hoeken/ESP32-S3-Template/ESP32-S3-Template.kicad_pcb

## KiCad design ESP32-S3-Template.kicad_pcb (2025-10-02)

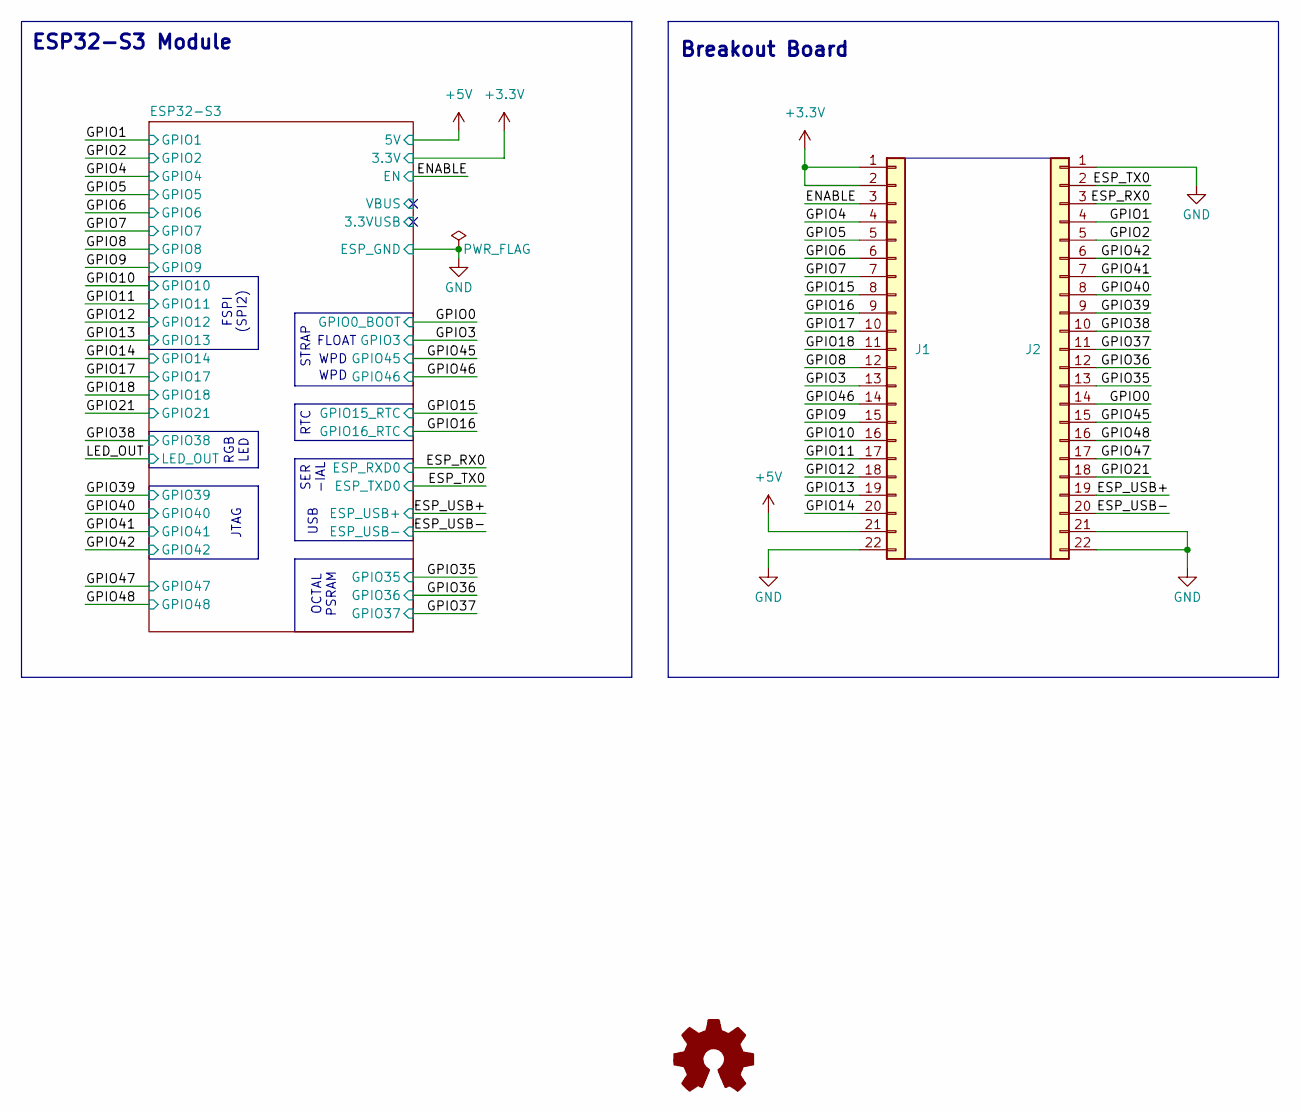
[picture p1: schematic ESP32-S3-Template.kicad_sch]

Parts:
J1, J2: Conn_01x22; PinHeader_1x22_P2.54mm_Vertical
S1: Logo_Open_Hardware_Small; OSHW-Logo_5.7x6mm_SilkScreen

Connections:
+3.3V: J1.1, J1.2; also elsewhere on the board
+5V: J1.21; also elsewhere on the board
/ENABLE: J1.3; also elsewhere on the board
/ESP_RX0: J2.3; also elsewhere on the board
/ESP_TX0: J2.2; also elsewhere on the board
/ESP_USB+: J2.19; also elsewhere on the board
/ESP_USB-: J2.20; also elsewhere on the board
/GPIO0: J2.14; also elsewhere on the board
/GPIO1: J2.4; also elsewhere on the board
/GPIO2: J2.5; also elsewhere on the board
/GPIO3: J1.13; also elsewhere on the board
/GPIO4: J1.4; also elsewhere on the board
/GPIO5: J1.5; also elsewhere on the board
/GPIO6: J1.6; also elsewhere on the board
/GPIO7: J1.7; also elsewhere on the board
/GPIO8: J1.12; also elsewhere on the board
/GPIO9: J1.15; also elsewhere on the board
/GPIO10: J1.16; also elsewhere on the board
/GPIO11: J1.17; also elsewhere on the board
/GPIO12: J1.18; also elsewhere on the board
/GPIO13: J1.19; also elsewhere on the board
/GPIO14: J1.20; also elsewhere on the board
/GPIO15: J1.8; also elsewhere on the board
/GPIO16: J1.9; also elsewhere on the board
/GPIO17: J1.10; also elsewhere on the board
/GPIO18: J1.11; also elsewhere on the board
/GPIO21: J2.18; also elsewhere on the board
/GPIO35: J2.13; also elsewhere on the board
/GPIO36: J2.12; also elsewhere on the board
/GPIO37: J2.11; also elsewhere on the board
/GPIO38: J2.10; also elsewhere on the board
/GPIO39: J2.9; also elsewhere on the board
/GPIO40: J2.8; also elsewhere on the board
/GPIO41: J2.7; also elsewhere on the board
/GPIO42: J2.6; also elsewhere on the board
/GPIO45: J2.15; also elsewhere on the board
/GPIO46: J1.14; also elsewhere on the board
/GPIO47: J2.17; also elsewhere on the board
/GPIO48: J2.16; also elsewhere on the board
GND: J1.22, J2.1, J2.21, J2.22; also elsewhere on the board

Notes on the sheet:
RTC
FSPI (SPI2)
WPD
FLOAT
Breakout Board
STRAP
ESP32-S3 Module
RGB LED
JTAG
OCTAL PSRAM
SER -IAL
USB

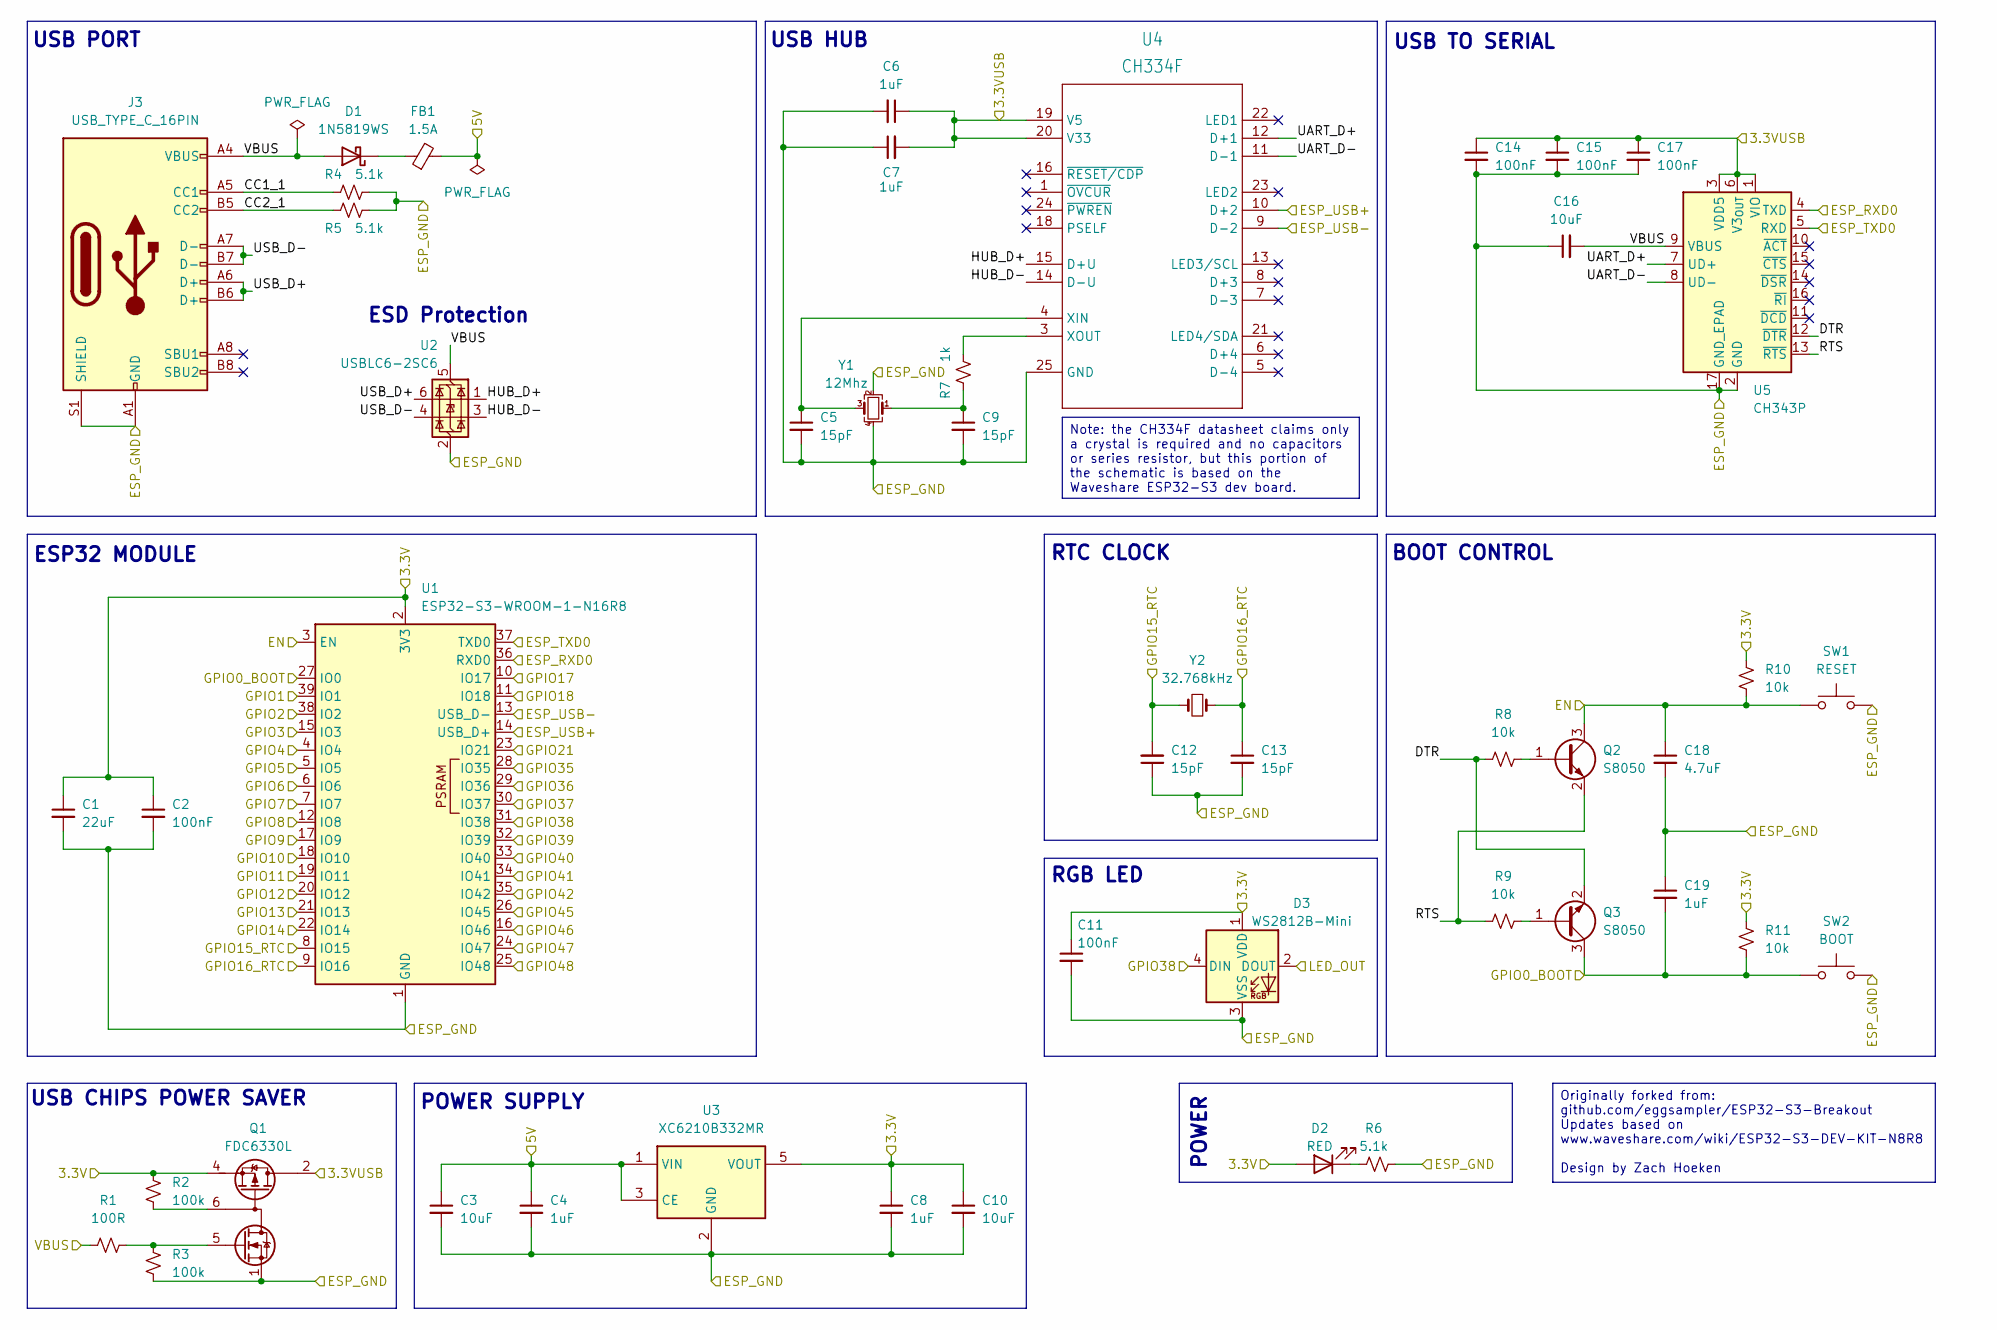
[picture p2: schematic esp32-s3.kicad_sch, https://github.com/hoeken/ESP32-S3-Template]

Parts:
C1: 22uF; C_0603_1608Metric
C2, C11, C14, C15, C17: 100nF; C_0603_1608Metric
C3, C10, C16: 10uF; C_0603_1608Metric
C4, C6, C7, C8, C19: 1uF; C_0603_1608Metric
C5, C9, C12, C13: 15pF; C_0603_1608Metric
C18: 4.7uF; C_0603_1608Metric
D1: 1N5819WS; D_SOD-323; LCSC C191023
D2: RED; LED_0603_1608Metric; LCSC C965799
D3: WS2812B-Mini; LED_WS2812B-Mini_PLCC4_3.5x3.5mm; LCSC C527089
FB1: 1.5A; Fuse_1206_3216Metric; LCSC C2760275
J3: USB_TYPE_C_16PIN; USB_C_Receptacle_GCT_USB4105-xx-A_16P_TopMnt_Horizontal; LCSC C393939
Q1: FDC6330L; TSOT-23-6; LCSC C112086
Q2, Q3: S8050; SOT-23; LCSC C916390
R1: 100R; R_0603_1608Metric
R2, R3: 100k; R_0603_1608Metric
R4, R5, R6: 5.1k; R_0603_1608Metric
R7: 1k; R_0603_1608Metric
R8, R9, R10, R11: 10k; R_0603_1608Metric
SW1: RESET; SW_Tactile_SPST_Angled_PTS645Vx58-2LFS; LCSC C557599
SW2: BOOT; SW_Tactile_SPST_Angled_PTS645Vx58-2LFS; LCSC C557599
U1: ESP32-S3-WROOM-1-N16R8; ESP32-S3-WROOM-1; LCSC C2913202
U2: USBLC6-2SC6; SOT-23-6; LCSC C7519
U3: XC6210B332MR; SOT-23-5; LCSC C424705
U4: CH334F; QFN-24-1EP_4x4mm_P0.5mm_EP2.7x2.7mm_ThermalVias; LCSC C5187527
U5: CH343P; QFN-16-1EP_3x3mm_P0.5mm_EP1.7x1.7mm_ThermalVias; LCSC C2846043
Y1: 12Mhz; Crystal_SMD_SeikoEpson_TSX3225-4Pin_3.2x2.5mm; LCSC C9002
Y2: 32.768kHz; Crystal_SMD_3215-2Pin_3.2x1.5mm; LCSC C97606

Connections:
+3.3V: C1.1, C2.1, C8.1, C10.1, C11.1, D2.2 (A), D3.1 (VDD), Q1.4 (S2), R2.2, R10.1, R11.2, U1.2 (3V3), U3.5 (VOUT); also elsewhere on the board
+5V: C3.1, C4.1, FB1.2, U3.1 (VIN), U3.3 (CE); also elsewhere on the board
/ENABLE: C18.1, Q2.3 (C), R10.2, SW1.1, U1.3 (EN); also elsewhere on the board
/ESP32-S3/3.3VUSB: C6.1, C7.2, C14.1, C15.1, C17.1, Q1.2 (D2), Q1.3 (D2), U4.19 (V5), U4.20 (V33), U5.1 (VIO), U5.3 (VDD5), U5.6 (V3_{OUT})
/ESP32-S3/CC1_1: J3.A5 (CC1), R4.1
/ESP32-S3/CC2_1: J3.B5 (CC2), R5.1
/ESP32-S3/DTR: Q3.2 (E), R8.1, U5.12 (~DTR)
/ESP32-S3/HUB_D+: U2.1 (I/O1), U4.15 (D+U)
/ESP32-S3/HUB_D-: U2.3 (I/O2), U4.14 (D-U)
/ESP32-S3/RTS: Q2.2 (E), R9.1, U5.13 (~RTS)
/ESP32-S3/UART_D+: U4.12 (D+1), U5.7 (UD+)
/ESP32-S3/UART_D-: U4.11 (D-1), U5.8 (UD-)
/ESP32-S3/USB_D+: J3.A6 (D+), J3.B6 (D+), U2.6 (I/O1)
/ESP32-S3/USB_D-: J3.A7 (D-), J3.B7 (D-), U2.4 (I/O2)
/ESP32-S3/VBUS: C16.2, D1.2 (A), J3.A4 (VBUS), J3.A9 (VBUS), J3.B4 (VBUS), J3.B9 (VBUS), R1.2, U2.5 (VBUS), U5.9 (VBUS)
/ESP_RX0: U1.36 (RXD0), U5.4 (TXD); also elsewhere on the board
/ESP_TX0: U1.37 (TXD0), U5.5 (RXD); also elsewhere on the board
/ESP_USB+: U1.14 (USB_D+), U4.10 (D+2); also elsewhere on the board
/ESP_USB-: U1.13 (USB_D-), U4.9 (D-2); also elsewhere on the board
/GPIO0: C19.2, Q3.3 (C), R11.1, SW2.1, U1.27 (IO0); also elsewhere on the board
/GPIO1: U1.39 (IO1); also elsewhere on the board
/GPIO2: U1.38 (IO2); also elsewhere on the board
/GPIO3: U1.15 (IO3); also elsewhere on the board
/GPIO4: U1.4 (IO4); also elsewhere on the board
/GPIO5: U1.5 (IO5); also elsewhere on the board
/GPIO6: U1.6 (IO6); also elsewhere on the board
/GPIO7: U1.7 (IO7); also elsewhere on the board
/GPIO8: U1.12 (IO8); also elsewhere on the board
/GPIO9: U1.17 (IO9); also elsewhere on the board
/GPIO10: U1.18 (IO10); also elsewhere on the board
/GPIO11: U1.19 (IO11); also elsewhere on the board
/GPIO12: U1.20 (IO12); also elsewhere on the board
/GPIO13: U1.21 (IO13); also elsewhere on the board
/GPIO14: U1.22 (IO14); also elsewhere on the board
/GPIO15: C12.2, U1.8 (IO15), Y2.2; also elsewhere on the board
/GPIO16: C13.1, U1.9 (IO16), Y2.1; also elsewhere on the board
/GPIO17: U1.10 (IO17); also elsewhere on the board
/GPIO18: U1.11 (IO18); also elsewhere on the board
/GPIO21: U1.23 (IO21); also elsewhere on the board
/GPIO35: U1.28 (IO35); also elsewhere on the board
/GPIO36: U1.29 (IO36); also elsewhere on the board
/GPIO37: U1.30 (IO37); also elsewhere on the board
/GPIO38: D3.4 (DIN), U1.31 (IO38); also elsewhere on the board
/GPIO39: U1.32 (IO39); also elsewhere on the board
/GPIO40: U1.33 (IO40); also elsewhere on the board
/GPIO41: U1.34 (IO41); also elsewhere on the board
/GPIO42: U1.35 (IO42); also elsewhere on the board
/GPIO45: U1.26 (IO45); also elsewhere on the board
/GPIO46: U1.16 (IO46); also elsewhere on the board
/GPIO47: U1.24 (IO47); also elsewhere on the board
/GPIO48: U1.25 (IO48); also elsewhere on the board
/LED_OUT: D3.2 (DOUT)
GND: C1.2, C2.2, C3.2, C4.2, C5.2, C6.2, C7.1, C8.2, C9.2, C10.2, C11.2, C12.1, C13.2, C14.2, C15.2, C16.1, C17.2, C18.2, C19.1, D3.3 (VSS), J3.A1 (GND), J3.A12 (GND), J3.B1 (GND), J3.B12 (GND), J3.S1 (SHIELD), Q1.1 (S1), R3.1, R4.2, R5.2, R6.2, SW1.2, SW2.2, U1.1 (GND), U1.40 (GND), U1.41 (GND), U2.2 (GND), U3.2 (GND), U4.25 (GND), U5.2 (GND), U5.17 (GND_EPAD), Y1.2, Y1.4; also elsewhere on the board
unnamed: C9.1, R7.1, Y1.1
unnamed: D1.1 (K), FB1.1
unnamed: D2.1 (K), R6.1
unnamed: Q1.6 (D1), R2.1
unnamed: Q1.5 (G1), R1.1, R3.2
unnamed: Q2.1 (B), R8.2
unnamed: Q3.1 (B), R9.2
unnamed: C5.1, U4.4 (XIN), Y1.3
unnamed: R7.2, U4.3 (XOUT)

Notes on the sheet:
RTC CLOCK
USB TO SERIAL
USB HUB
POWER
BOOT CONTROL
USB CHIPS POWER SAVER
ESD Protection
ESP32 MODULE
RGB LED
POWER SUPPLY
USB PORT
Note: the CH334F datasheet claims only a crystal is required and no capacitors or series resistor, but this portion of the schematic is based on the Waveshare ESP32-S3 dev board.
Originally forked from: github.com/eggsampler/ESP32-S3-Breakout Updates based on www.waveshare.com/wiki/ESP32-S3-DEV-KIT-N8R8 Design by Zach Hoeken

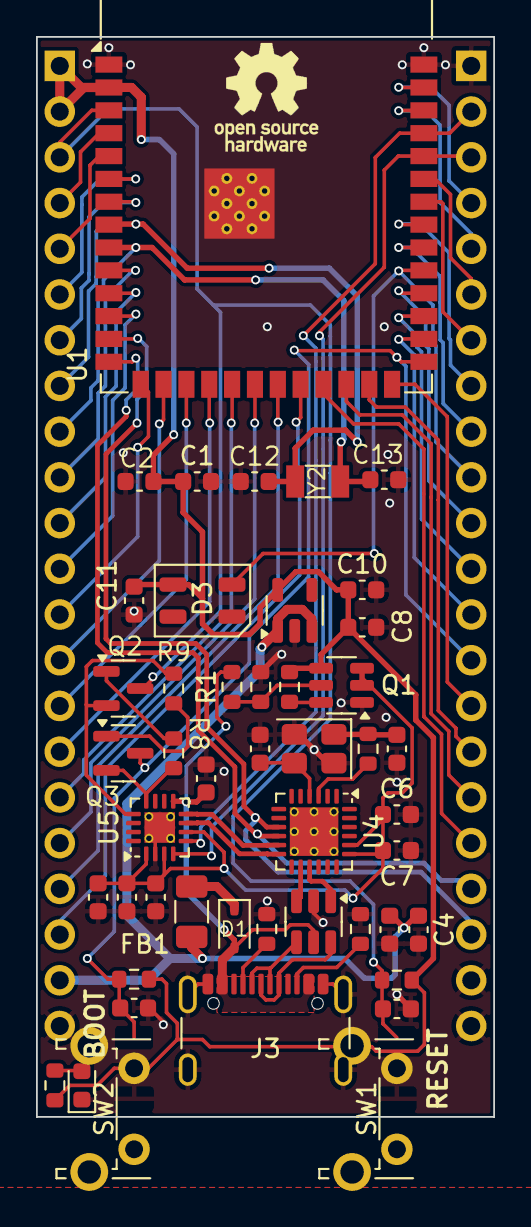
[picture p3: board ESP32-S3-Template.kicad_pcb from above]

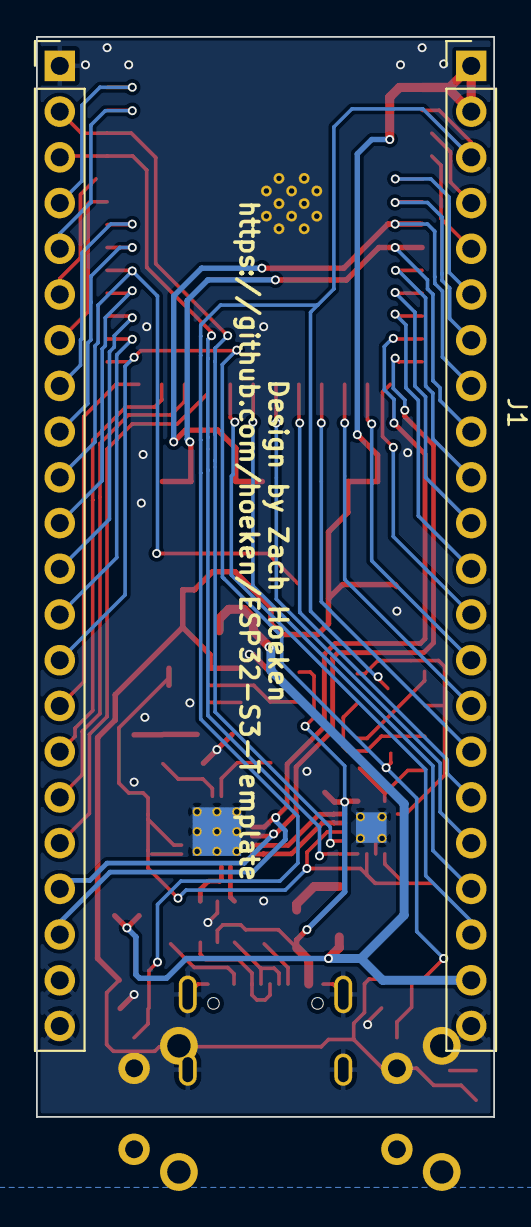
[picture p4: board ESP32-S3-Template.kicad_pcb from below]

Board: 4 copper layers, 25.4 x 60.0 mm, 50 parts (2 on the bottom side), 61 nets.
