hoeken/ESP32-S3-Template/(commit log)

2025-08-20 initial group of modifications.
    [ESP32-S3-Breakout.kicad_pcb, ESP32-S3-Breakout.kicad_sch, esp32-s3.kicad_sch]
2025-08-21 board is fully routed.
    [ESP32-S3-Breakout.kicad_pcb, ESP32-S3-Breakout.kicad_sch, esp32-s3.kicad_sch]
2025-08-22 fully routed, erc+drc pass, 3d models
    [ESP32-S3-Breakout.kicad_pcb, ESP32-S3-Breakout.kicad_sch, esp32-s3.kicad_sch]
2025-08-22 a little bit of a reorg
    [ESP32-S3-Template.kicad_pcb, ESP32-S3-Template.kicad_sch, esp32-s3.kicad_sch]
2025-08-22 checking bom
    [ESP32-S3-Template.kicad_sch]
2025-08-23 reworked the esp module symbol with more pin info.
    [ESP32-S3-Template.kicad_sch]
2025-08-28 i think its ready for reddit.
    [ESP32-S3-Template.kicad_pcb, esp32-s3.kicad_sch]
2025-08-29 another full pass over the schematic and layout
    [ESP32-S3-Template.kicad_pcb, ESP32-S3-Template.kicad_sch, esp32-s3.kicad_sch]
2025-10-02 pulled in brineomatic version
    [ESP32-S3-Template.kicad_pcb, ESP32-S3-Template.kicad_sch, esp32-s3.kicad_sch]
